lab-laia/minimalistiCE/README.md

# Welcome to the oi project!

#### minimalistiCE is a complete, modular Capillary Electrophoresis (CE) instrument with Capacitively Coupled Contactless Conductivity Detection (C<sup>4</sup>D) and —best of all— is **fully open source** and mostly 3D-printed!

Here you can find everything needed to build and operate the equipment:
- Documentation: [DOCUMENTATION folder](https://github.com/lab-laia/minimalistiCE/tree/main/DOCUMENTATION)
- CAD files and schematics for PCBs: [HARDWARE folder](https://github.com/lab-laia/minimalistiCE/tree/main/HARDWARE)
- Firmware and front end: [SOFTWARE folder](https://github.com/lab-laia/minimalistiCE/tree/main/SOFTWARE)

A step-by-step roadmap (also available in full in the documentation folder):

1. **System description:** list of minimalistiCE’s systems and components, and how they are organized and interact  
2. **Bill of Materials (BOM):** complete list of parts required to build the equipment  
3. **3D Printing:** guide to get the most out of the printed parts  
4. **Construction Guide:** comprehensive, step-by-step hardware assembly and software installation  
5. **Operation Guide:** instructions to run the instrument and obtain results  

It is assumed that the builder/user has at least basic knowledge of electronics/electrical work, Arduino programming, and familiarity with CE. CE is a separation technique that employs high voltages (up to 30 kV) and must be handled with care and respect.

Happy building!

###### © 2025 Claudimir Lucio do Lago and Ivan Verlangieri. Hardware designs are licensed under CERN-OHL-P v2.0, software under the MIT License, and documentation under Creative Commons Attribution 4.0 International (CC BY 4.0). See the respective LICENSE files for full terms.
