lab-laia/minimalistiCE/SOFTWARE/firmware/minimalistiCE_007/Comunicação minimalistiCE.docx

Comunicação com o Equipamento de Eletroforese Capilar minimalistiCE

do Lago, Claudimir Lucio

Comunicação com o Equipamento de Eletroforese Capilar minimalistiCE

São Paulo, 2025

Copyright © 2025 by Claudimir Lucio do Lago

Índice Geral

## Introdução

A comunicação se dá através da porta serial (USB) entre o computador e a microcontroladora geral e desta com os dispositivos I²C. Cada dispositivo I²C possui um endereço na rede cujo master é a microcontroladora geral:

/* I2C devices */

const byte I2C_HVpowerSource = 19;

Neste caso, 19 é o endereço I²C da fonte de alta tensão (HV). Não há, no entanto, que se preocupar com este endereço, pois ele é manipulado internamente pela microcontroladora. Para atuar sobre a fonte HV, basta enviar os comandos Serine descritos na seção correspondente.

Sobre a rede formada, estão instalados os dispositivos virtuais, os quais são identificados nas mensagens através de um rótulo de um caractere (ID):

// Virtual devices living in this microcontroller

SerineVirtualDevice detectorVD = { 'd', "SdL013003" };

SerineVirtualDevice highVoltageVD = { 'h', "tHighVoltage" };

O ID deve ser considerado na comunição. Assim, no exemplo, para comunicação com a fonte HV, o ID a ser considerado é “h”, enquanto que “d” permite comunicar com o detector.

As strings de comando são formadas de acordo com o protocolo Serine (https://github.com/claudimir-lago/Serine-Protocol). Lembrar que caracteres abaixo de espaço (#32) são suprimidos na composição da string. Assim, um campo numérico, quando necessário, deve conter '0' ao invés de espaços nos dígitos à esquerda. A terminação '\0' (caractere nulo) é necessária em linguagem C e Java para compor a string e deve ser computada no comprimento total da mesma:

0 | 1 | 2 | 3 | 4 | 5 | 6 | 7 | 8 | 9 | 10 | 11 | 12 | 13 | 14 | 15 | 16 | 17 | 18 | 19 | 20 | 21 | 22 | 23 | 24 | 25 | 26 | 27 | 28 | 29 | 30 | 31
| | | | | | | | | | | | | | | | | | | | | | | | | | | | | | ; | \0

## ~~Comunicação com~~ ~~a Controladora Geral~~ ~~(Modificar)~~

Nos comandos a seguir, ‘x’ é sempre o remetente, o qual, via de regra, é o microcomputador ('m').

### Connect

Avisa a microcontroladora que a porta UART de comunicação com o microcomputador foi identificada pelo programa de controle e aquisição de dados.

string de comando:

0 | 1 | 2 | 3 | 4 | 5 | 6 | 7 | 8 | 9 | 10 | 11 | 12 | 13 | 14 | 15 | 16 | 17 | 18 | 19 | 20 | 21 | 22 | 23 | 24 | 25 | 26 | 27 | 28 | 29 | 30 | 31
g | x | X | ; | \0

string de retorno:

0 | 1 | 2 | 3 | 4 | 5 | 6 | 7 | 8 | 9 | 10 | 11 | 12 | 13 | 14 | 15 | 16 | 17 | 18 | 19 | 20 | 21 | 22 | 23 | 24 | 25 | 26 | 27 | 28 | 29 | 30 | 31
x | g | X | ; | \0

### On

Liga o equipamento caso esteja em standby.

string de comando:

0 | 1 | 2 | 3 | 4 | 5 | 6 | 7 | 8 | 9 | 10 | 11 | 12 | 13 | 14 | 15 | 16 | 17 | 18 | 19 | 20 | 21 | 22 | 23 | 24 | 25 | 26 | 27 | 28 | 29 | 30 | 31
g | x | N | ; | \0

### Off

Desliga as fontes e coloca o equipamento em standby.

string de comando:

0 | 1 | 2 | 3 | 4 | 5 | 6 | 7 | 8 | 9 | 10 | 11 | 12 | 13 | 14 | 15 | 16 | 17 | 18 | 19 | 20 | 21 | 22 | 23 | 24 | 25 | 26 | 27 | 28 | 29 | 30 | 31
g | x | F | ; | \0

### Run

Inicia um experimento (injeção seguida de separação eletroforética) programado anteriormente.

string de comando:

0 | 1 | 2 | 3 | 4 | 5 | 6 | 7 | 8 | 9 | 10 | 11 | 12 | 13 | 14 | 15 | 16 | 17 | 18 | 19 | 20 | 21 | 22 | 23 | 24 | 25 | 26 | 27 | 28 | 29 | 30 | 31
g | x | R | i | a | f | f | ; | \0

i – '1' para realizar injeção programada, '0' para não injetar.

a – '1' para autorizar abortar corrida em caso de porta aberta, '0' para ignorar abertura de porta.

f – número de dois dígitos informando a quantidade de sinais de fuga de alta tensão (GFI) que causam o aborto do programa. "00" para ignorar as fugas de alta tensão.

string de retorno:

0 | 1 | 2 | 3 | 4 | 5 | 6 | 7 | 8 | 9 | 10 | 11 | 12 | 13 | 14 | 15 | 16 | 17 | 18 | 19 | 20 | 21 | 22 | 23 | 24 | 25 | 26 | 27 | 28 | 29 | 30 | 31
x | g | R | n | ; | \0

n – retorna a causa do encerramento do programa: 0 – finalização normal do programa; 1 – fuga de alta tensão; 2 – porta aberta; 3 – interrupção solicitada por software; 4 – equipamento sendo desligado.

### Halt

Interrompe um experimento em andamento.

string de comando:

0 | 1 | 2 | 3 | 4 | 5 | 6 | 7 | 8 | 9 | 10 | 11 | 12 | 13 | 14 | 15 | 16 | 17 | 18 | 19 | 20 | 21 | 22 | 23 | 24 | 25 | 26 | 27 | 28 | 29 | 30 | 31
g | x | H | ; | \0

### Status

Solicita informações sobre o status do equipamento. A mensagem de retorno pode ser gerada espontaneamente pelo equipamento sempre que alguma condição digna de nota deva ser observada pelo microcomputador.

string de comando:

0 | 1 | 2 | 3 | 4 | 5 | 6 | 7 | 8 | 9 | 10 | 11 | 12 | 13 | 14 | 15 | 16 | 17 | 18 | 19 | 20 | 21 | 22 | 23 | 24 | 25 | 26 | 27 | 28 | 29 | 30 | 31
g | x | S | ; | \0

string de retorno:

0 | 1 | 2 | 3 | 4 | 5 | 6 | 7 | 8 | 9 | 10 | 11 | 12 | 13 | 14 | 15 | 16 | 17 | 18 | 19 | 20 | 21 | 22 | 23 | 24 | 25 | 26 | 27 | 28 | 29 | 30 | 31
x | g | S | n | t | p1 | p2 | p3 | r | e | f | ; | \0

n – retorna 1 se o equipamento estiver ligado, 0 se estiver em standby.

t – retorna 1 se o termostato estiver ligado.

py – retorna 1 se a porta y estiver aberta.

r – retorna 1 se o programa de um experimento estiver rodando.

e – retorna 1 se a fonte de alta tensão estiver habilitada.

f – retorna 1 se for identificada fuga de alta tensão.

### Keyboard

Emula o acionamento do teclado do painel do equipamento. A mensagem de retorno contendo o número de acionamentos é gerada tanto para um acionamento real do teclado, quanto em resposta ao comando de emulação do teclado.

string de comando:

0 | 1 | 2 | 3 | 4 | 5 | 6 | 7 | 8 | 9 | 10 | 11 | 12 | 13 | 14 | 15 | 16 | 17 | 18 | 19 | 20 | 21 | 22 | 23 | 24 | 25 | 26 | 27 | 28 | 29 | 30 | 31
g | x | K | n | ; | \0

string de retorno:

0 | 1 | 2 | 3 | 4 | 5 | 6 | 7 | 8 | 9 | 10 | 11 | 12 | 13 | 14 | 15 | 16 | 17 | 18 | 19 | 20 | 21 | 22 | 23 | 24 | 25 | 26 | 27 | 28 | 29 | 30 | 31
x | g | K | n | ; | \0

n – número de acionamentos.

### LED

Liga e desliga os LEDs de sinalização.

string de comando:

0 | 1 | 2 | 3 | 4 | 5 | 6 | 7 | 8 | 9 | 10 | 11 | 12 | 13 | 14 | 15 | 16 | 17 | 18 | 19 | 20 | 21 | 22 | 23 | 24 | 25 | 26 | 27 | 28 | 29 | 30 | 31
g | x | A | a | b | ; | \0

a – 'N' liga e 'F' desliga os LEDs azuis.

b – 'N' liga e 'F' desliga os LEDs brancos.

### Injection Fan

Liga e desliga a ventoinha do módulo de injeção.

string de comando:

0 | 1 | 2 | 3 | 4 | 5 | 6 | 7 | 8 | 9 | 10 | 11 | 12 | 13 | 14 | 15 | 16 | 17 | 18 | 19 | 20 | 21 | 22 | 23 | 24 | 25 | 26 | 27 | 28 | 29 | 30 | 31
g | x | I | n | ; | \0

n – 'N' liga a ventoinha e 'F' desliga.

### Verbose Level

Determina o nível de verbosidade do equipamento.

string de comando:

0 | 1 | 2 | 3 | 4 | 5 | 6 | 7 | 8 | 9 | 10 | 11 | 12 | 13 | 14 | 15 | 16 | 17 | 18 | 19 | 20 | 21 | 22 | 23 | 24 | 25 | 26 | 27 | 28 | 29 | 30 | 31
g | x | L | n | ; | \0

n:

'0' coloca o equipamento no nível mais baixo de verbosidade. Neste nível, todas as informações devem ser solicitadas através de comandos explícitos. A única exceção é a mensagem gerada pela tecla do equipamento.

'1' para um nível intermediário, similar ao nível '0', porém com leituras automáticas dos conversores A/D durante a injeção e a corrida. Este é o nível mais apropriado para controle direto do equipamento via terminal de comunicação serial.

'2' para o nível máximo de verbosidade. Neste caso, o status e as leituras dos conversores são gerados automaticamente, mantendo o cliente amplamente atualizado sobre o funcionamento do equipamento. Este nível é o mais adequado para ser utilizado com um front end completo.

### Unknown Address

Retorno no caso de um comando ser enviado a um destinatário inválido.

string de retorno:

0 | 1 | 2 | 3 | 4 | 5 | 6 | 7 | 8 | 9 | 10 | 11 | 12 | 13 | 14 | 15 | 16 | 17 | 18 | 19 | 20 | 21 | 22 | 23 | 24 | 25 | 26 | 27 | 28 | 29 | 30 | 31
x | g | ? | y | ; | \0

y – destinatário inválido.

### Escape

Limpa uma linha de comando que esteja sendo enviada. Este comando deve ser utilizado em casos de eventual dúvida no conjunto de caracteres que já foram enviados, ou quando se deseja limpar o buffer de comunicação. Este é o único comando que não termina com ";". Na realidade, não é necessário compor uma string; basta o envio do caractere "#" para que a linha de comando seja limpa.

string de comando:

0 | 1 | 2 | 3 | 4 | 5 | 6 | 7 | 8 | 9 | 10 | 11 | 12 | 13 | 14 | 15 | 16 | 17 | 18 | 19 | 20 | 21 | 22 | 23 | 24 | 25 | 26 | 27 | 28 | 29 | 30 | 31
# | \0 | | | | | | | | | | | | | | | | | | | | | | | | | | | | | ; | \0

## ~~Comunicação com~~ ~~o Injetor~~ ~~(modificar)~~

Nos comandos a seguir, x é sempre o remetente.

### Program Press & Hold

Estabelece os tempos de pressurização e de retenção.

string de comando:

0 | 1 | 2 | 3 | 4 | 5 | 6 | 7 | 8 | 9 | 10 | 11 | 12 | 13 | 14 | 15 | 16 | 17 | 18 | 19 | 20 | 21 | 22 | 23 | 24 | 25 | 26 | 27 | 28 | 29 | 30 | 31
i | x | P | p | p | p | p | p | p | p | p | h | h | h | h | h | h | h | h | ; | \0

p – tempo de pressurização, de 00 000 000 a 99 999 999 milissegundos.

h – tempo de retenção, de 00 000 000 a 99 999 999 milissegundos.

### Run

Realiza uma injeção como programado anteriormente.

string de comando:

0 | 1 | 2 | 3 | 4 | 5 | 6 | 7 | 8 | 9 | 10 | 11 | 12 | 13 | 14 | 15 | 16 | 17 | 18 | 19 | 20 | 21 | 22 | 23 | 24 | 25 | 26 | 27 | 28 | 29 | 30 | 31
i | x | R | ; | \0

### Halt

Aborta a injeção.

string de comando:

0 | 1 | 2 | 3 | 4 | 5 | 6 | 7 | 8 | 9 | 10 | 11 | 12 | 13 | 14 | 15 | 16 | 17 | 18 | 19 | 20 | 21 | 22 | 23 | 24 | 25 | 26 | 27 | 28 | 29 | 30 | 31
i | x | H | ; | \0

### Status

Retorna algumas condições de funcionamento da fonte.

string de comando:

0 | 1 | 2 | 3 | 4 | 5 | 6 | 7 | 8 | 9 | 10 | 11 | 12 | 13 | 14 | 15 | 16 | 17 | 18 | 19 | 20 | 21 | 22 | 23 | 24 | 25 | 26 | 27 | 28 | 29 | 30 | 31
i | x | S | ; | \0

string de retorno:

0 | 1 | 2 | 3 | 4 | 5 | 6 | 7 | 8 | 9 | 10 | 11 | 12 | 13 | 14 | 15 | 16 | 17 | 18 | 19 | 20 | 21 | 22 | 23 | 24 | 25 | 26 | 27 | 28 | 29 | 30 | 31
x | i | S | y | ; | \0

y – retorna '1' se estiver injetando ou '0' em caso contrário.

## Comunicação com a Fonte HV

Nos comandos a seguir, x é sempre o remetente.

### Get

Informa qual o tempo desde o último comando Run e o valor atual de potencial e correntes.

string de comando:

0 | 1 | 2 | 3 | 4 | 5 | 6 | 7 | 8 | 9 | 10 | 11 | 12 | 13 | 14 | 15 | 16 | 17 | 18 | 19 | 20 | 21 | 22 | 23 | 24 | 25 | 26 | 27 | 28 | 29 | 30 | 31
h | x | G | ; | \0

string de retorno:

0 | 1 | 2 | 3 | 4 | 5 | 6 | 7 | 8 | 9 | 10 | 11 | 12 | 13 | 14 | 15 | 16 | 17 | 18 | 19 | 20 | 21 | 22 | 23 | 24 | 25 | 26 | 27 | 28 | 29 | 30 | 31
x | h | G | t | t | t | t | t | t | t | s | v | v | v | v | v | iT | iT | iT | iT | iT | iT | iR | iR | iR | iR | iR | iR | ; | \0

t – tempo (em milissegundos). Número inteiro positivo de 7 dígitos.

s – sinal ("+" ou "-") do potencial.

v – potencial (entre 00 000 e 30 000 V).

iT – corrente total (entre 000 000 e 300 000 nA).

iR – corrente de retorno (entre 000 000 e 300 000 nA).

### Program

Permite acrescentar uma etapa de programação até um máximo de 5 etapas.

string de comando:

0 | 1 | 2 | 3 | 4 | 5 | 6 | 7 | 8 | 9 | 10 | 11 | 12 | 13 | 14 | 15 | 16 | 17 | 18 | 19 | 20 | 21 | 22 | 23 | 24 | 25 | 26 | 27 | 28 | 29 | 30 | 31
h | x | P | t | t | t | t | t | t | t | s | v | v | v | v | v | i | i | i | i | i | i | ; | \0

t – tempo (em milissegundos) no qual o potencial e a corrente devem ser atingidos. Número inteiro positivo de 7 dígitos.

s – sinal ("+" ou "-") do potencial e, consequentemente, da corrente.

v – potencial (entre 00 000 e 30 000 V).

i – corrente de retorno (entre 000 000 e 300 000 nA).

### Status

Retorna algumas condições de funcionamento da fonte.

string de comando:

0 | 1 | 2 | 3 | 4 | 5 | 6 | 7 | 8 | 9 | 10 | 11 | 12 | 13 | 14 | 15 | 16 | 17 | 18 | 19 | 20 | 21 | 22 | 23 | 24 | 25 | 26 | 27 | 28 | 29 | 30 | 31
h | x | S | ; | \0

string de retorno:

0 | 1 | 2 | 3 | 4 | 5 | 6 | 7 | 8 | 9 | 10 | 11 | 12 | 13 | 14 | 15 | 16 | 17 | 18 | 19 | 20 | 21 | 22 | 23 | 24 | 25 | 26 | 27 | 28 | 29 | 30 | 31
x | h | S | g | r | e | p | v | i | ; | \0

g – 1 se GFI (ground fault indicator) da fonte estiver ativo e 0 se estiver normal. Alerta sobre possível problema com o acoplamento de terra.

r – 1 se estiver rodando programa e 0 em caso contrário.

e – 1 se a fonte estiver habilitada e 0 se estiver desabilitada.

p – 1 se estiver no modo positivo e 0 se estiver no modo negativo.

v – 1 se estiver no modo de tensão controlada e 0 se não estiver.

i – 1 se estiver no modo de corrente controlada e 0 se não estiver.

### Run

Inicia a execução do programa que está na memória. O cronômetro é zerado; portanto, as leituras de tempo passam a se referir ao momento que este comando foi executado. A fonte de alta tensão, que via de regra fica desabilitada por motivos de segurança, é automaticamente habilitada até que o programa seja encerrado.

string de comando:

0 | 1 | 2 | 3 | 4 | 5 | 6 | 7 | 8 | 9 | 10 | 11 | 12 | 13 | 14 | 15 | 16 | 17 | 18 | 19 | 20 | 21 | 22 | 23 | 24 | 25 | 26 | 27 | 28 | 29 | 30 | 31
h | x | R | ; | \0

### Enable

Habilita a saída da fonte de alta tensão. Deve se tomar cuidado ao enviar este comando, pois não é feita qualquer checagem sobre a adequação de se aplicar alta tensão naquele momento.

string de comando:

0 | 1 | 2 | 3 | 4 | 5 | 6 | 7 | 8 | 9 | 10 | 11 | 12 | 13 | 14 | 15 | 16 | 17 | 18 | 19 | 20 | 21 | 22 | 23 | 24 | 25 | 26 | 27 | 28 | 29 | 30 | 31
h | x | E | ; | \0

### Disable

Desabilita a saída da fonte de alta tensão. Isto, no entanto, não zera os registros de tensão e corrente que estavam em uso. Portanto, a condição inicial pode ser restaurada pelo comando Enable.

string de comando:

0 | 1 | 2 | 3 | 4 | 5 | 6 | 7 | 8 | 9 | 10 | 11 | 12 | 13 | 14 | 15 | 16 | 17 | 18 | 19 | 20 | 21 | 22 | 23 | 24 | 25 | 26 | 27 | 28 | 29 | 30 | 31
h | x | D | ; | \0

### Halt

O potencial e a corrente são ajustadas para zero e a fonte é desabilitada. Caso um programa esteja em curso, este é abortado.

string de comando:

0 | 1 | 2 | 3 | 4 | 5 | 6 | 7 | 8 | 9 | 10 | 11 | 12 | 13 | 14 | 15 | 16 | 17 | 18 | 19 | 20 | 21 | 22 | 23 | 24 | 25 | 26 | 27 | 28 | 29 | 30 | 31
h | x | H | ; | \0

### Frozen

Interrompe momentaneamente o avanço do programa da fonte. A fonte continua ativa nas condições que vinha operando até então. O comando Unfrozen reverte esta situação.

string de comando:

0 | 1 | 2 | 3 | 4 | 5 | 6 | 7 | 8 | 9 | 10 | 11 | 12 | 13 | 14 | 15 | 16 | 17 | 18 | 19 | 20 | 21 | 22 | 23 | 24 | 25 | 26 | 27 | 28 | 29 | 30 | 31
h | x | F | ; | \0

### Unfrozen

Reverte uma condição de parada temporária do programa estabelecido pelo comando Frozen.

string de comando:

0 | 1 | 2 | 3 | 4 | 5 | 6 | 7 | 8 | 9 | 10 | 11 | 12 | 13 | 14 | 15 | 16 | 17 | 18 | 19 | 20 | 21 | 22 | 23 | 24 | 25 | 26 | 27 | 28 | 29 | 30 | 31
h | x | U | ; | \0

### Beep

Gera um sinal sonoro de 200 ms.

string de comando:

0 | 1 | 2 | 3 | 4 | 5 | 6 | 7 | 8 | 9 | 10 | 11 | 12 | 13 | 14 | 15 | 16 | 17 | 18 | 19 | 20 | 21 | 22 | 23 | 24 | 25 | 26 | 27 | 28 | 29 | 30 | 31
h | x | B | ; | \0

### Clear

Interrompe imediatamente um programa, caso esteja sendo rodado, e limpa todos os passos de programação.

string de comando:

0 | 1 | 2 | 3 | 4 | 5 | 6 | 7 | 8 | 9 | 10 | 11 | 12 | 13 | 14 | 15 | 16 | 17 | 18 | 19 | 20 | 21 | 22 | 23 | 24 | 25 | 26 | 27 | 28 | 29 | 30 | 31
h | x | C | ; | \0

## Comunicação com o C⁴D

### Zero

This command reinitiates the chronometer.

Command string:

0 | 1 | 2 | 3 | 4 | 5 | 6 | 7 | 8 | 9 | 10 | 11 | 12 | 13 | 14 | 15 | 16 | 17 | 18 | 19 | 20 | 21 | 22 | 23 | 24 | 25 | 26 | 27 | 28 | 29 | 30 | 31 | 32
d | x | Z | ; | \0

### Get

This command instructs the virtual device to send back the values of the A/D converters. It is possible to put the virtual device in a continuous mode sending each new value obtained from the ADCs, as well as to instruct about the data format.

Command string:

0 | 1 | 2 | 3 | 4 | 5 | 6 | 7 | 8 | 9 | 10 | 11 | 12 | 13 | 14 | 15 | 16 | 17 | 18 | 19 | 20 | 21 | 22 | 23 | 24 | 25 | 26 | 27 | 28 | 29 | 30 | 31 | 32
d | m | G | y | ; | \0

y – 'r' sets the continuous mode; 'h' halts the continuous mode; ‘w’ waits for the external start; ‘t’ waits for the external start and stop. Any other option will result in just one instantaneous get.

Return string:

0 | 1 | 2 | 3 | 4 | 5 | 6 | 7 | 8 | 9 | 10 | 11 | 12 | 13 | 14 | 15 | 16 | 17 | 18 | 19 | 20 | 21 | 22 | 23 | 24 | 25 | 26 | 27 | 28 | 29 | 30 | 31 | 32
m | d | g | t | t | t | t | t | t | t | aw | aw | aw | aw | aw | aw | aw | ax | ax | ax | ax | ax | ax | ax | ; | \0

t – time in milliseconds (seven digits).

aw a az – readings (from 0 to 4,194,304) of the ADCs 0 and 1.

## ~~Exemplos~~ ~~(atualizar)~~

Os exemplos a seguir podem ser utilizados como um todo ou em partes como sugestões para implementações em programas de controle ou como mensagens a serem enviadas através de um terminal serial. Deve-se atentar para a identificação da porta serial e seus parâmetros de configuração.

Vale lembrar que os comandos podem ser enviados como uma única string ou através da utilização de espaços, tabulações e mudanças de linhas.

### Reconhecendo a presença de um equipamento em uma determinada porta

Quando o equipamento é ligado, o módulo geral começa a regularmente enviar um retorno do comando Status. Por exemplo:

mgS0-------;mgS0-------;mgS0-------;mgS0-------;

Esta string de retorno deve ser interpretada como "o equipamento está ligado, porém em standby". Como provavelmente este será o único dispositivo que estará transmitindo uma string semelhante, ainda que não seja conhecida a porta de comunicação, pode-se identificá-la simplesmente monitorando-as sucessivamente até que tais strings comecem a ser recebidas.

### Estabelecendo conexão e ligando o equipamento

A transmissão contínua de um retorno de Status (exemplo anterior) é indicativa de que o equipamento ainda não foi reconhecido. Ao se enviar o comando gmX;, o equipamento retornará mgX;. A partir deste momento, o equipamento está ciente de que foi reconhecido e não mais enviará o retorno de Status.

A qualquer momento, o equipamento pode ser ligado, enviando-se o comando On (gmN;) e desligado através do comando Off (gmF;).

### Programando um experimento

O exemplo a seguir (1) configura o detector para fazer a leitura dos dois detectores de condutividade mais o sensor de pressão, (2) configura o injetor para pressurizar durante 1,234 s e reter a pressão por 5,555 s, (3) o programa anterior da fonte de alta tensão é eliminado e (4) duas etapas são programadas para que a fonte atinja 30000 V em 1,234 s e permaneça assim até os 20 s de corrida.

#dmC1110;

imP0000123400005555;

hmC;

hmP0001234+30000100000;

hmP0020000+30000100000;

O comando scape no início da transmissão não é obrigatório, mas garante que qualquer pendência anterior seja ignorada.

A fonte está sendo programada com tensão positiva, o que, via de regra, é apropriado para análise de ânions, pois a injeção é feita sempre do lado da baixa tensão. Para análise de cátions, provavelmente o usuário irá optar por tensão negativa. Como, no exemplo, a intenção era a de trabalhar no modo de tensão controlada, a corrente está sendo limitada em 100 µA.

### Ativando o termostato

No exemplo a seguir, o termostato será ativado após se estabelecer limites inferior e superior iguais a 21,0 ºC:

tmL21000; tmH21000; tmN;

### Executando um experimento

Uma vez tendo programado o injetor, o detector e a fonte de alta tensão, um experimento pode ser realizado com o comando Run:

gmR1145;

Neste caso, o experimento será realizado incluindo-se a etapa de injeção e será abortado caso uma das portas seja aberta ou em caso de se observar 45 mensagens de GFI da fonte de alta tensão.

A autorização para injeção ou início de corrida pode ser dada diretamente através do teclado do equipamento ou pelo envio de um comando de emulação de teclado:

gmK1;

Caso não seja desejado aguardar o tempo total de experimento programado, basta enviar o comando Halt (gmH;), o que implicará no recebimento da mensagem:

mgR3;

que significa que o experimento foi interrompido por software.
