lab-laia/minimalistiCE/HARDWARE/A/1/a/A.1.a.iii_.step

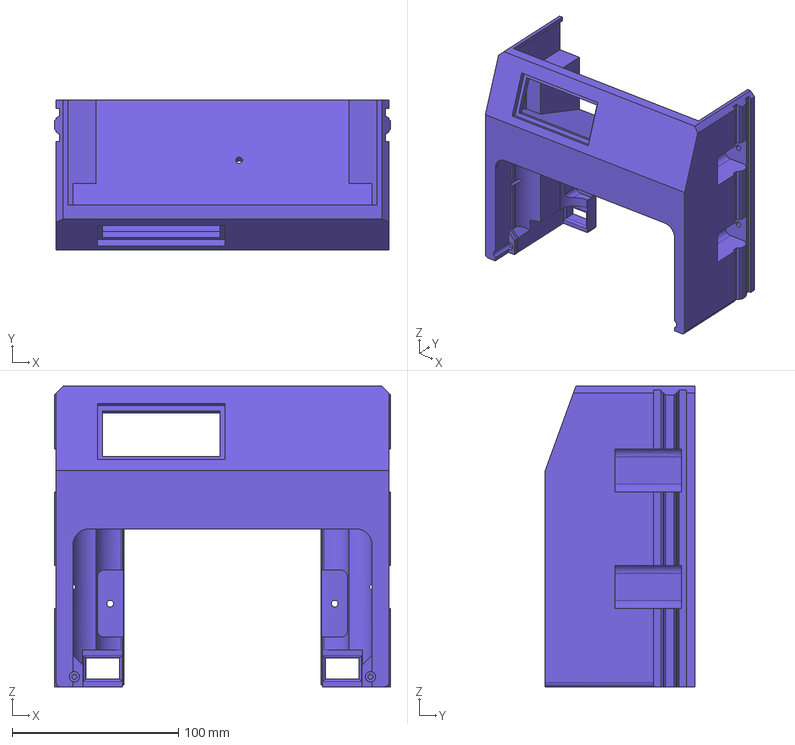
[picture p1: CAD file, 2025-12-18]
HARDWARE/A/1/a/A.1.a.iii_.step
202.0 x 90.0 x 180.7 mm
