lab-laia/minimalistiCE/HARDWARE/A/1/c/A.1.c.iv..step

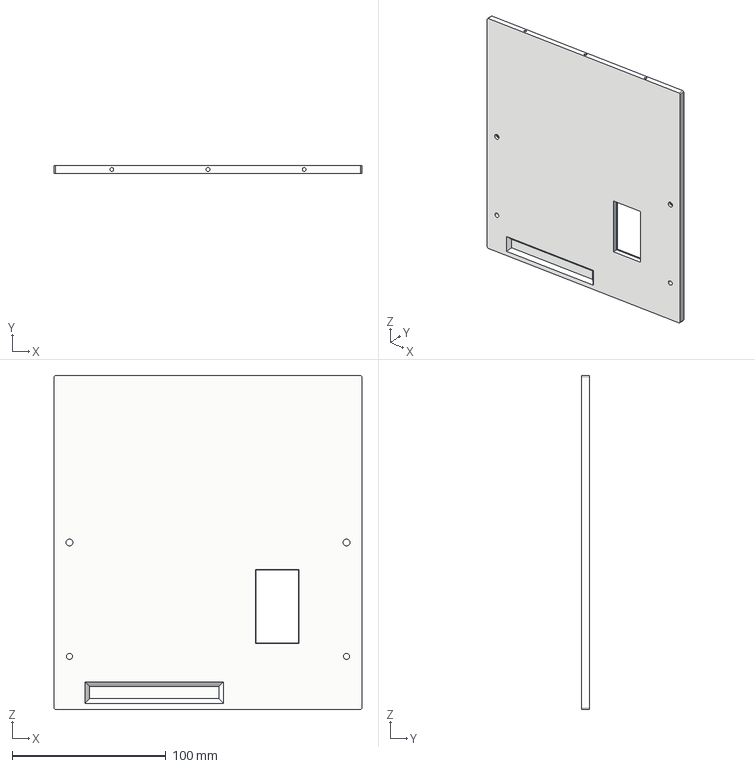
[picture p2: CAD file, 2025-12-18]
HARDWARE/A/1/c/A.1.c.iv..step
200.0 x 5.00 x 217.0 mm
