lab-laia/minimalistiCE/HARDWARE/A/1/d/A.1.d.i_.step

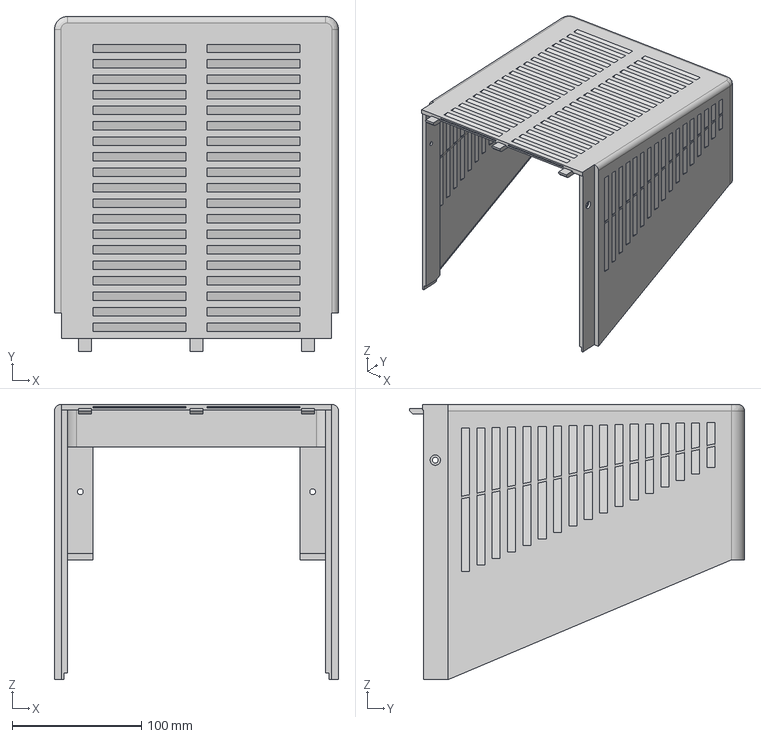
[picture p3: CAD file, 2025-12-11]
HARDWARE/A/1/d/A.1.d.i_.step
220.0 x 259.5 x 213.2 mm
