lab-laia/minimalistiCE/HARDWARE/A/3/A.3_.step

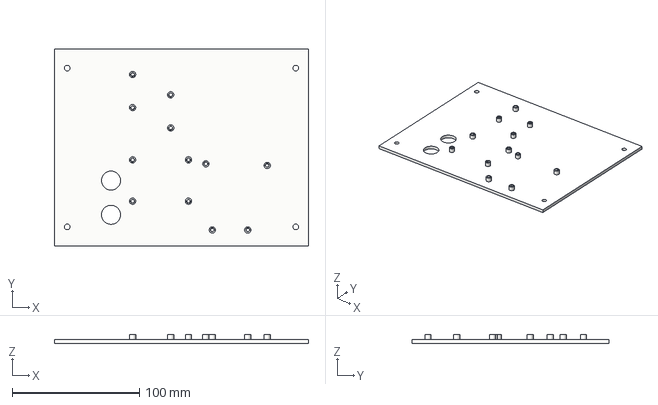
[picture p4: CAD file, 2025-12-18]
HARDWARE/A/3/A.3_.step
200.0 x 155.0 x 7.00 mm
