lab-laia/minimalistiCE/HARDWARE/B/3/b/B.3.b.ix.step

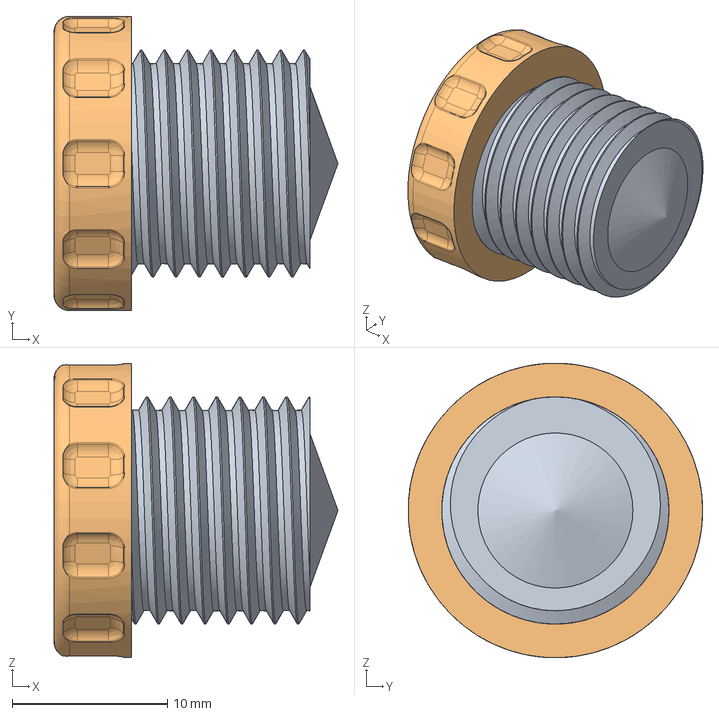
[picture p5: CAD file, 2026-10-15]
HARDWARE/B/3/b/B.3.b.ix.step
18.3 x 19.0 x 19.0 mm
