lab-laia/minimalistiCE/HARDWARE/B/3/d/B.3.d.iv..step

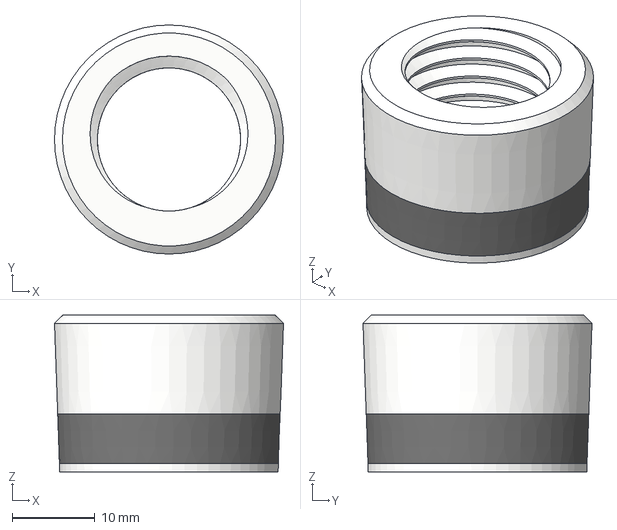
[picture p6: CAD file, 2025-12-11]
HARDWARE/B/3/d/B.3.d.iv..step
27.7 x 27.7 x 19.0 mm
