lab-laia/minimalistiCE/HARDWARE/A/1/a/A.1.a.iv_.step

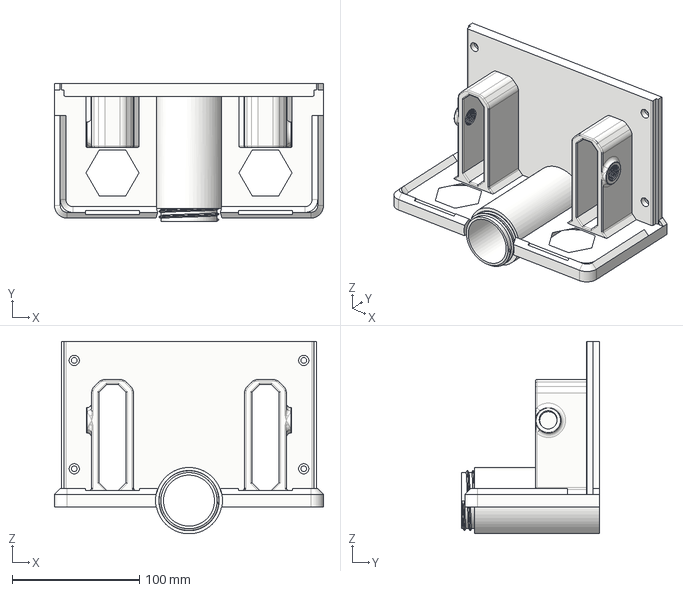
[picture p7: CAD file, 2025-12-16]
HARDWARE/A/1/a/A.1.a.iv_.step
211.0 x 108.0 x 151.0 mm
