lab-laia/minimalistiCE/HARDWARE/A/1/c/A.1.c.iii..step

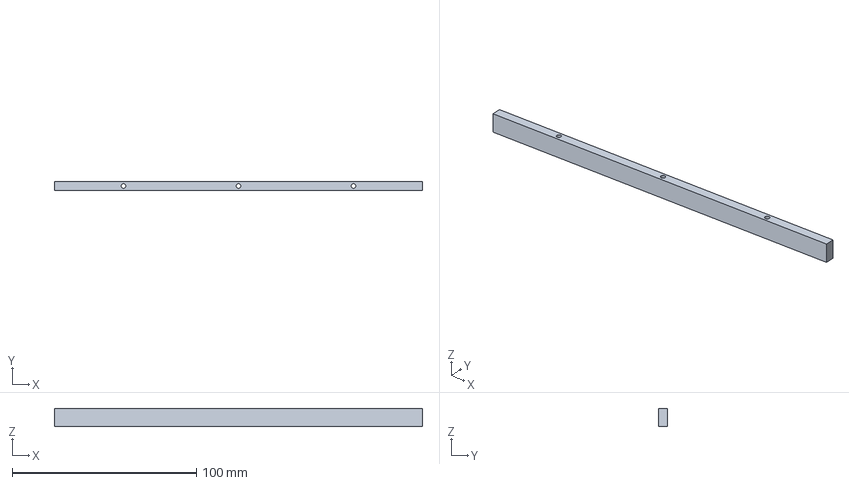
[picture p8: CAD file, 2025-12-18]
HARDWARE/A/1/c/A.1.c.iii..step
200.0 x 5.00 x 10.0 mm
