lab-laia/minimalistiCE/HARDWARE/B/3/b/B.3.b.vi_.step

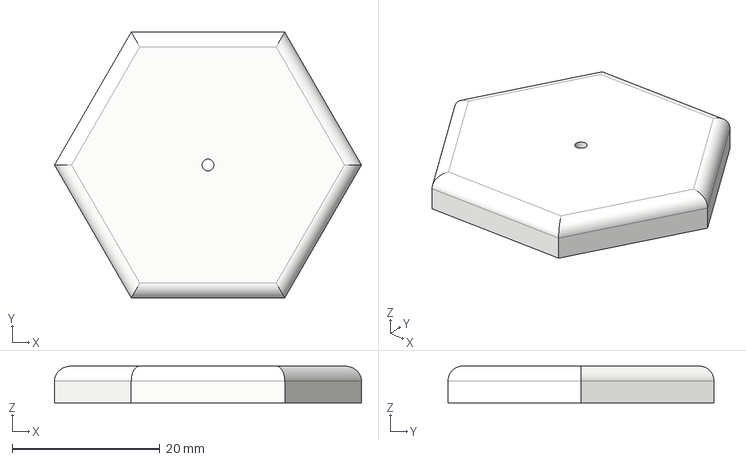
[picture p9: CAD file, 2025-12-11]
HARDWARE/B/3/b/B.3.b.vi_.step
41.6 x 36.0 x 5.00 mm
