lab-laia/minimalistiCE/HARDWARE/B/3/d/B.3.d.iii..step

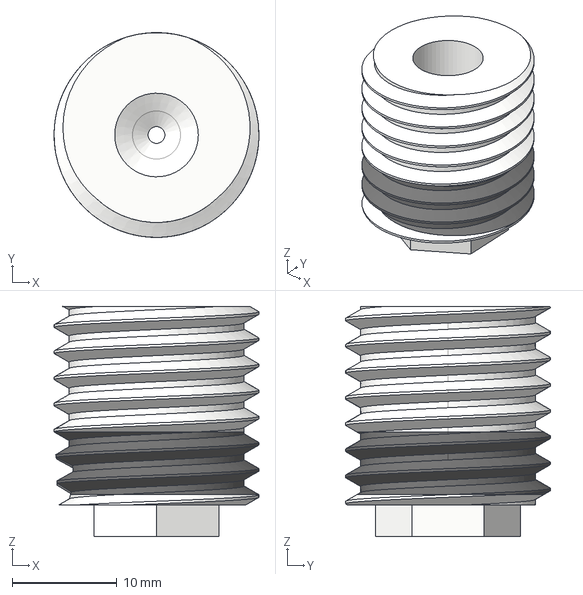
[picture p10: CAD file, 2025-12-11]
HARDWARE/B/3/d/B.3.d.iii..step
19.6 x 19.6 x 22.0 mm
