lab-laia/minimalistiCE/HARDWARE/A/1/c/A.1.c.i..step

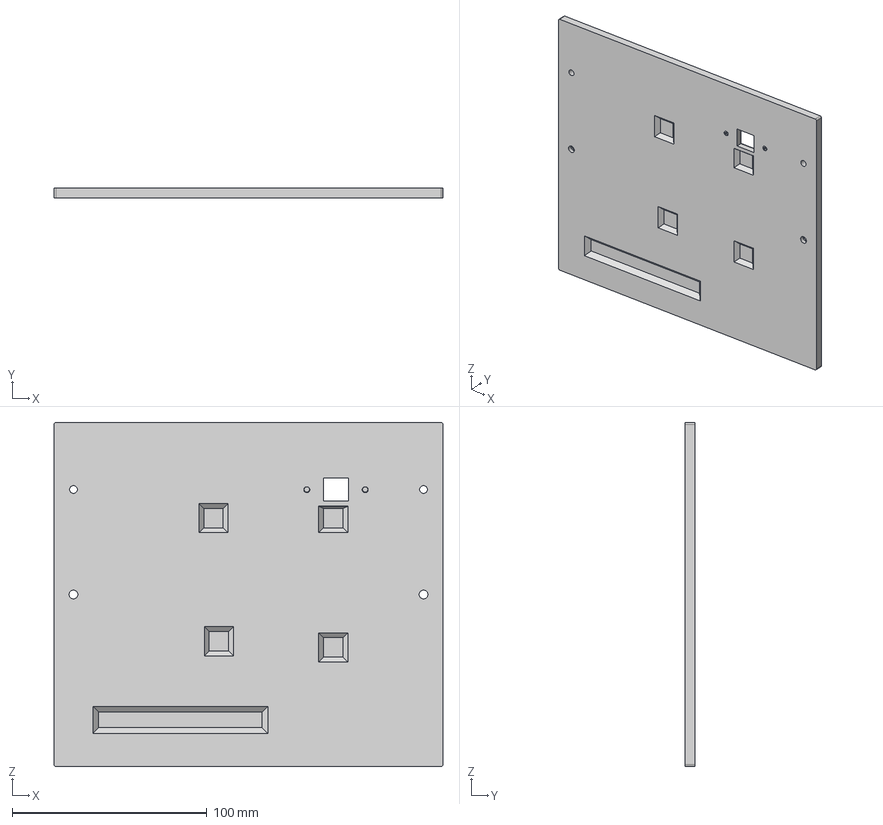
[picture p11: CAD file, 2025-12-18]
HARDWARE/A/1/c/A.1.c.i..step
200.0 x 5.00 x 177.0 mm
