lab-laia/minimalistiCE/HARDWARE/B/3/b/B.3.b.vii_.step

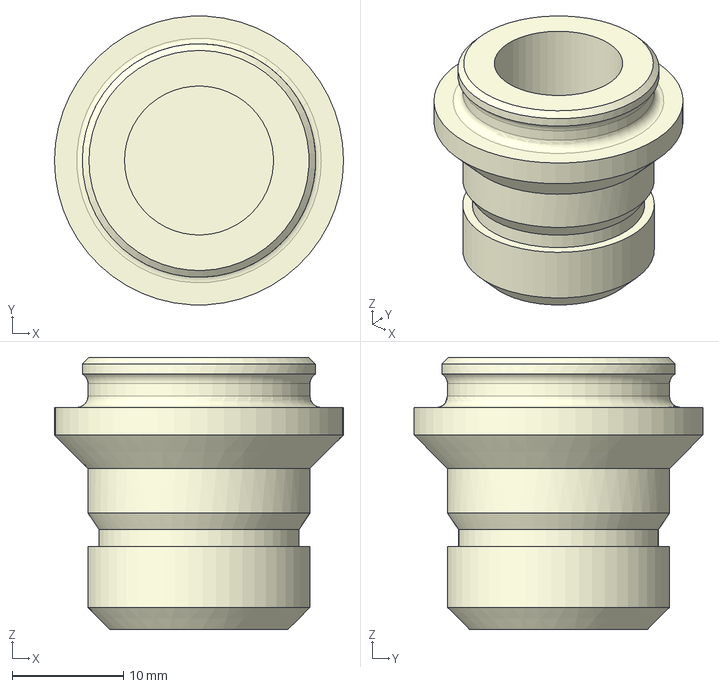
[picture p12: CAD file, 2025-12-11]
HARDWARE/B/3/b/B.3.b.vii_.step
26.0 x 26.0 x 24.5 mm
