lab-laia/minimalistiCE/HARDWARE/A/1/c/A.1.c.ii..step

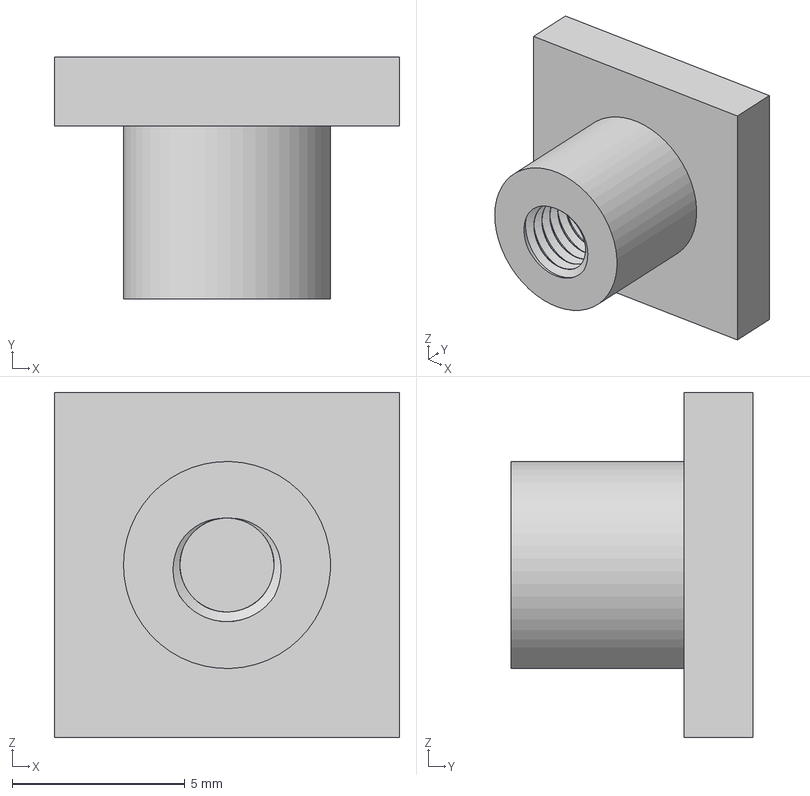
[picture p13: CAD file, 2025-12-18]
HARDWARE/A/1/c/A.1.c.ii..step
10.0 x 7.00 x 10.0 mm
