lab-laia/minimalistiCE/HARDWARE/B/3/b/B.3.b.viii..step

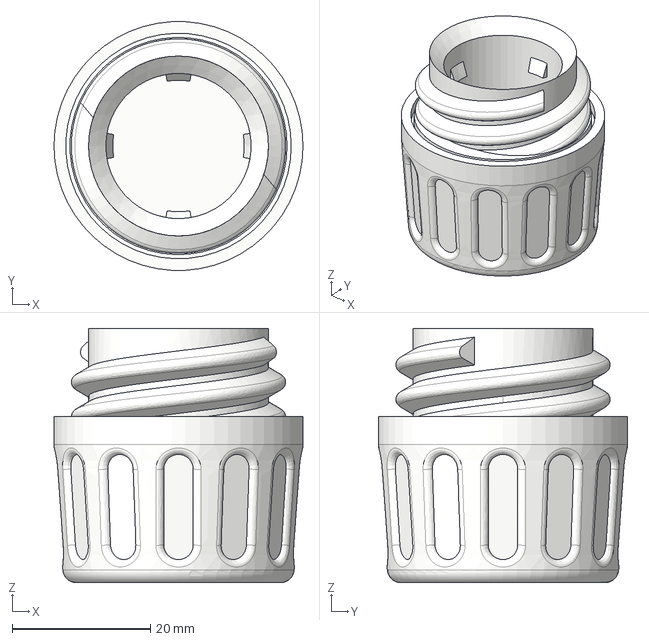
[picture p14: CAD file, 2025-12-11]
HARDWARE/B/3/b/B.3.b.viii..step
36.0 x 35.9 x 36.8 mm
