lab-laia/minimalistiCE/HARDWARE/B/3/b/B.3.b.v_.step

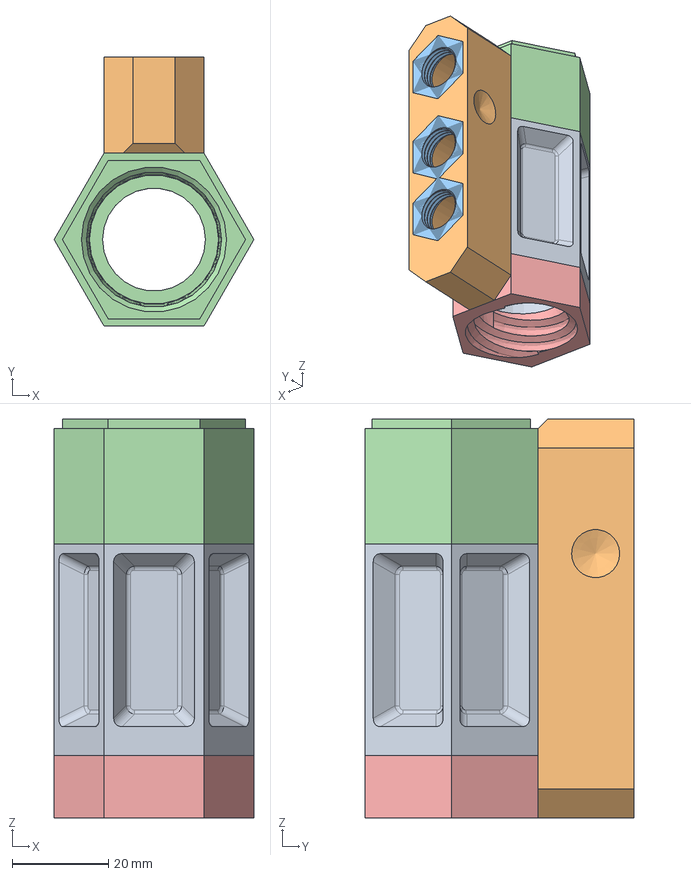
[picture p15: CAD file, 2025-12-11]
HARDWARE/B/3/b/B.3.b.v_.step
41.6 x 56.0 x 83.0 mm
