lab-laia/minimalistiCE/(list of files, cad)

Other CAD files:
HARDWARE/A/1/a/A.1.a.iii_.stl
HARDWARE/A/1/a/A.1.a.iv_.stl
HARDWARE/A/1/c/A.1.c.i..stl
HARDWARE/A/1/c/A.1.c.ii..stl
HARDWARE/A/1/c/A.1.c.iii..stl
HARDWARE/A/1/c/A.1.c.iv..stl
HARDWARE/A/1/d/A.1.d.i_.stl
HARDWARE/A/3/A.3_.stl
HARDWARE/B/3/b/B.3.b.ix_.stl
HARDWARE/B/3/b/B.3.b.v_.stl
HARDWARE/B/3/b/B.3.b.vi_.stl
HARDWARE/B/3/b/B.3.b.vii_.stl
HARDWARE/B/3/b/B.3.b.viii_.stl
HARDWARE/B/3/d/B.3.d.iii..stl
HARDWARE/B/3/d/B.3.d.iv..stl
