lab-laia/minimalistiCE/HARDWARE/B/3/d/B.3.d.i/fonte HV Darth Sch.pdf

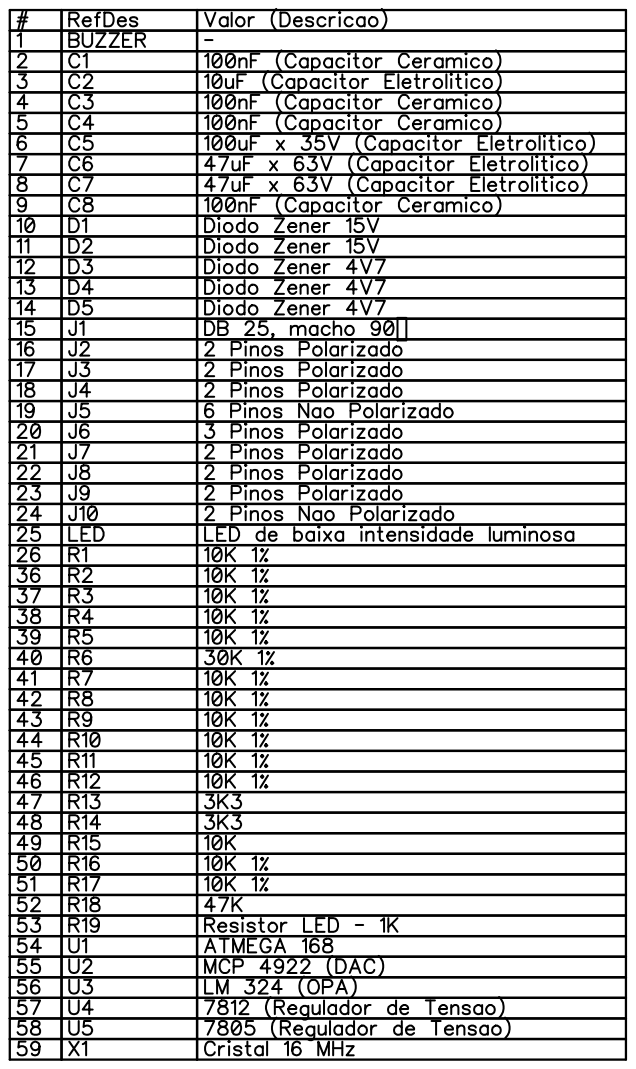
[picture p16: page 1]

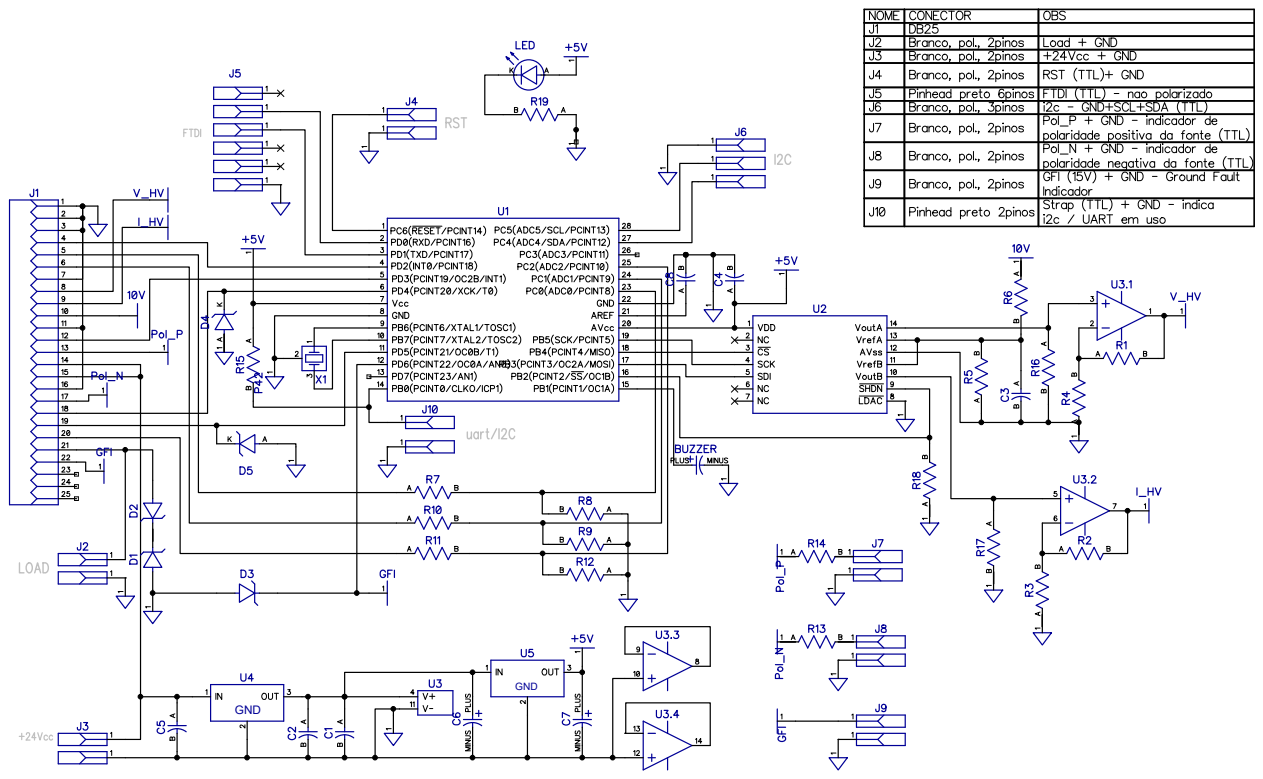
[picture p17: page 2]
GND
