lab-laia/minimalistiCE/HARDWARE/B/3/d/B.3.d.i/fonte HV Darth PCB.pdf

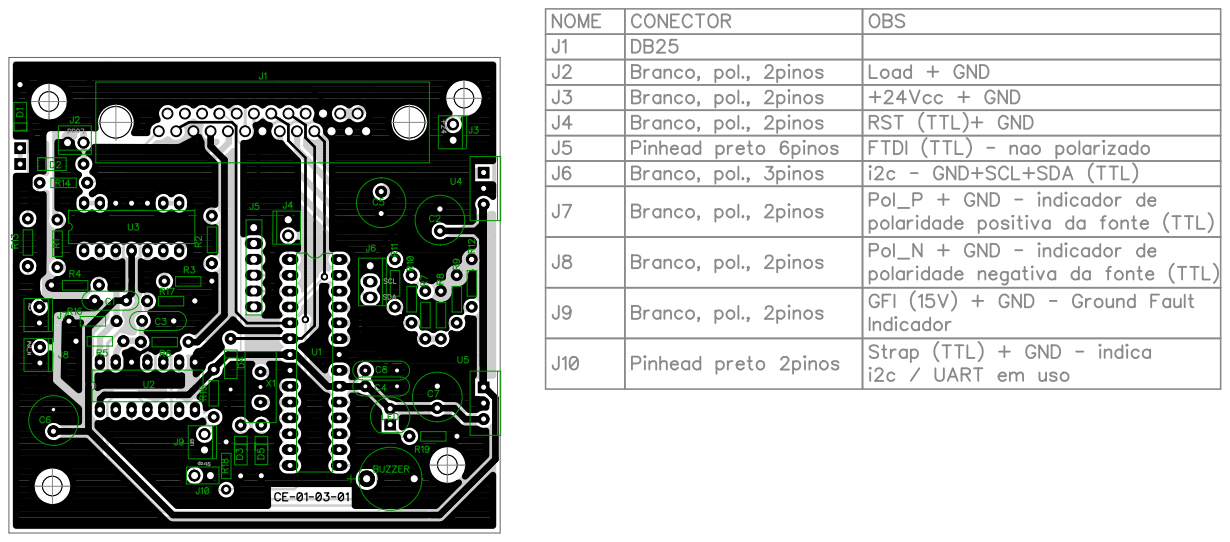
[picture p18: page 1]
