lab-laia/minimalistiCE/(commit log)

2025-12-11 Files upload
    [B.3.b.v_.step, B.3.b.v_.stl, B.3.b.vi_.step, B.3.b.vi_.stl, B.3.b.vii_.step, B.3.b.vii_.stl, B.3.b.viii..step, B.3.b.viii_.stl]
2025-12-11 File management
    [B.3.b.v_.step, B.3.b.v_.stl, B.3.b.vi_.step, B.3.b.vi_.stl, B.3.b.vii_.step, B.3.b.vii_.stl, B.3.b.viii..step, B.3.b.viii_.stl]
2025-12-12 Enhance README with open source and 3D printing details
    Added information about open source and 3D printing.
2025-12-12 Update README with 3D printing guide disclaimers
    Clarified disclaimers regarding 3D printing and hardware sourcing.
2025-12-15 Clarify CAD files and schematics in README
    Updated README to clarify CAD files and schematics availability.
